falsonix/picoAVE/production_gerbers/README.md

This directory contains pre-compiled gerber files that can be uploaded to a manufacturer like JLCPCB or PCBWay, along with the BOM.csv and Positions.csv files for assembly services.
