falsonix/picoAVE/hardware/hdmi_pcb/README.md

Adapted from https://github.com/wmi-0/wiihdmi/tree/master/hdmi_pcb/kicad

License: [GPL v3](https://github.com/wmi-0/wiihdmi/blob/master/LICENSE)
