falsonix/picoAVE/hardware/wii_flex/wii_flex.kicad_pcb

## KiCad design hardware/wii_flex/wii_flex.kicad_pcb (2025-01-12)

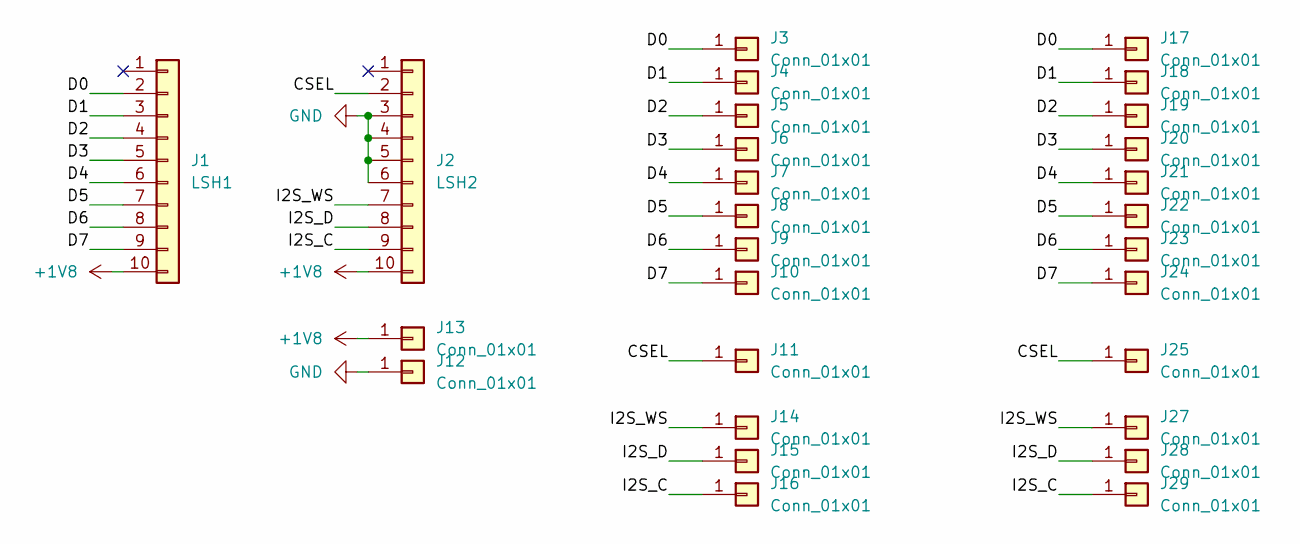
[picture p1: schematic wii_flex.kicad_sch]

Parts:
J1: LSH1; PinHeader_1x10_P2.54mm_Vertical
J2: LSH2; PinHeader_1x10_P2.54mm_Vertical
J3, J4, J5, J6, J7, J8, J9, J10, J11, J14, J15, J16, J17, J18, J19, J20, J21, J22, J23, J24, J25, J27, J28, J29: Conn_01x01; wii_pin
J12, J13: Conn_01x01; TestPoint_Pad_2.0x2.0mm

Connections:
+1V8: J1.10, J2.10, J13.1
/CSEL: J2.2, J11.1, J25.1
/D0: J1.2, J3.1, J17.1
/D1: J1.3, J4.1, J18.1
/D2: J1.4, J5.1, J19.1
/D3: J1.5, J6.1, J20.1
/D4: J1.6, J7.1, J21.1
/D5: J1.7, J8.1, J22.1
/D6: J1.8, J9.1, J23.1
/D7: J1.9, J10.1, J24.1
/I2S_C: J2.9, J16.1, J29.1
/I2S_D: J2.8, J15.1, J28.1
/I2S_WS: J2.7, J14.1, J27.1
GND: J2.3, J2.4, J2.5, J2.6, J12.1

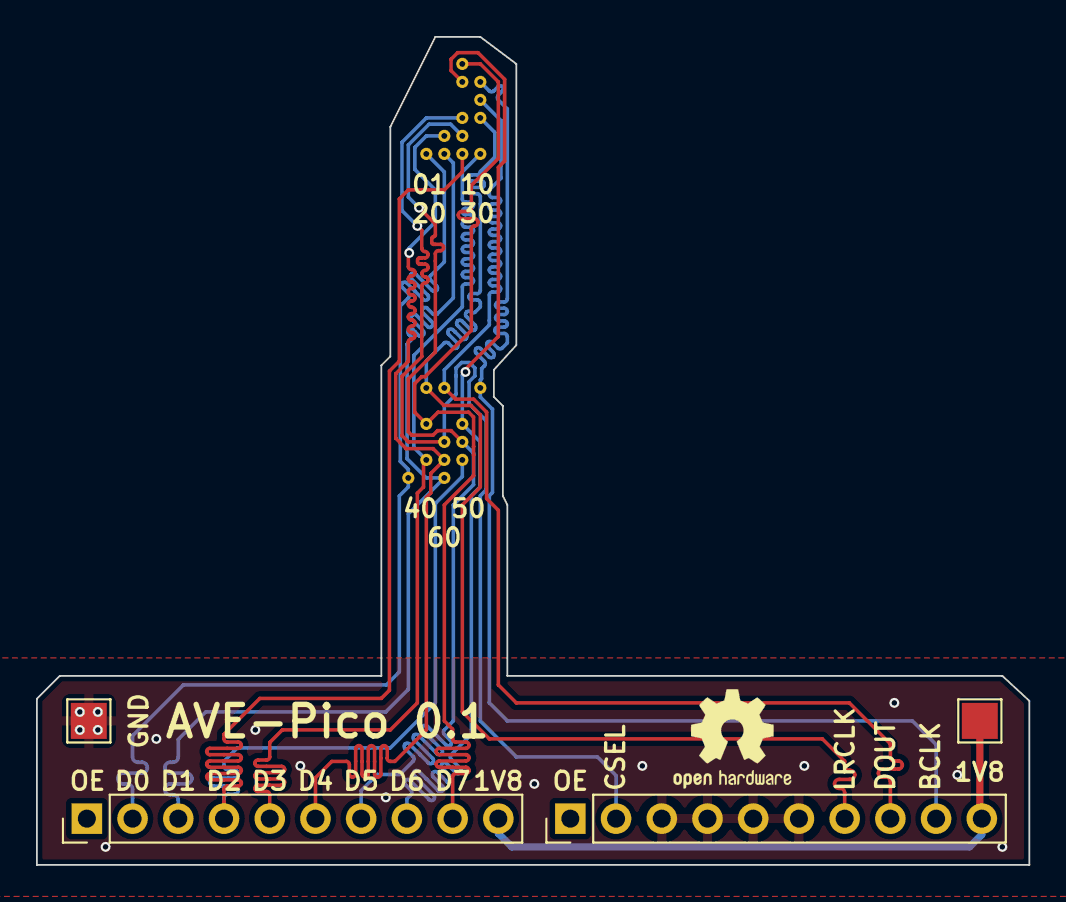
[picture p2: board wii_flex.kicad_pcb from above]

Board: 2 copper layers, 55.1 x 46.0 mm, 28 parts (0 on the bottom side), 14 nets.
