falsonix/picoAVE/hardware/hdmi_pcb/wii_hdmi_pcb.kicad_pcb

## KiCad design hardware/hdmi_pcb/wii_hdmi_pcb.kicad_pcb (2025-01-12)

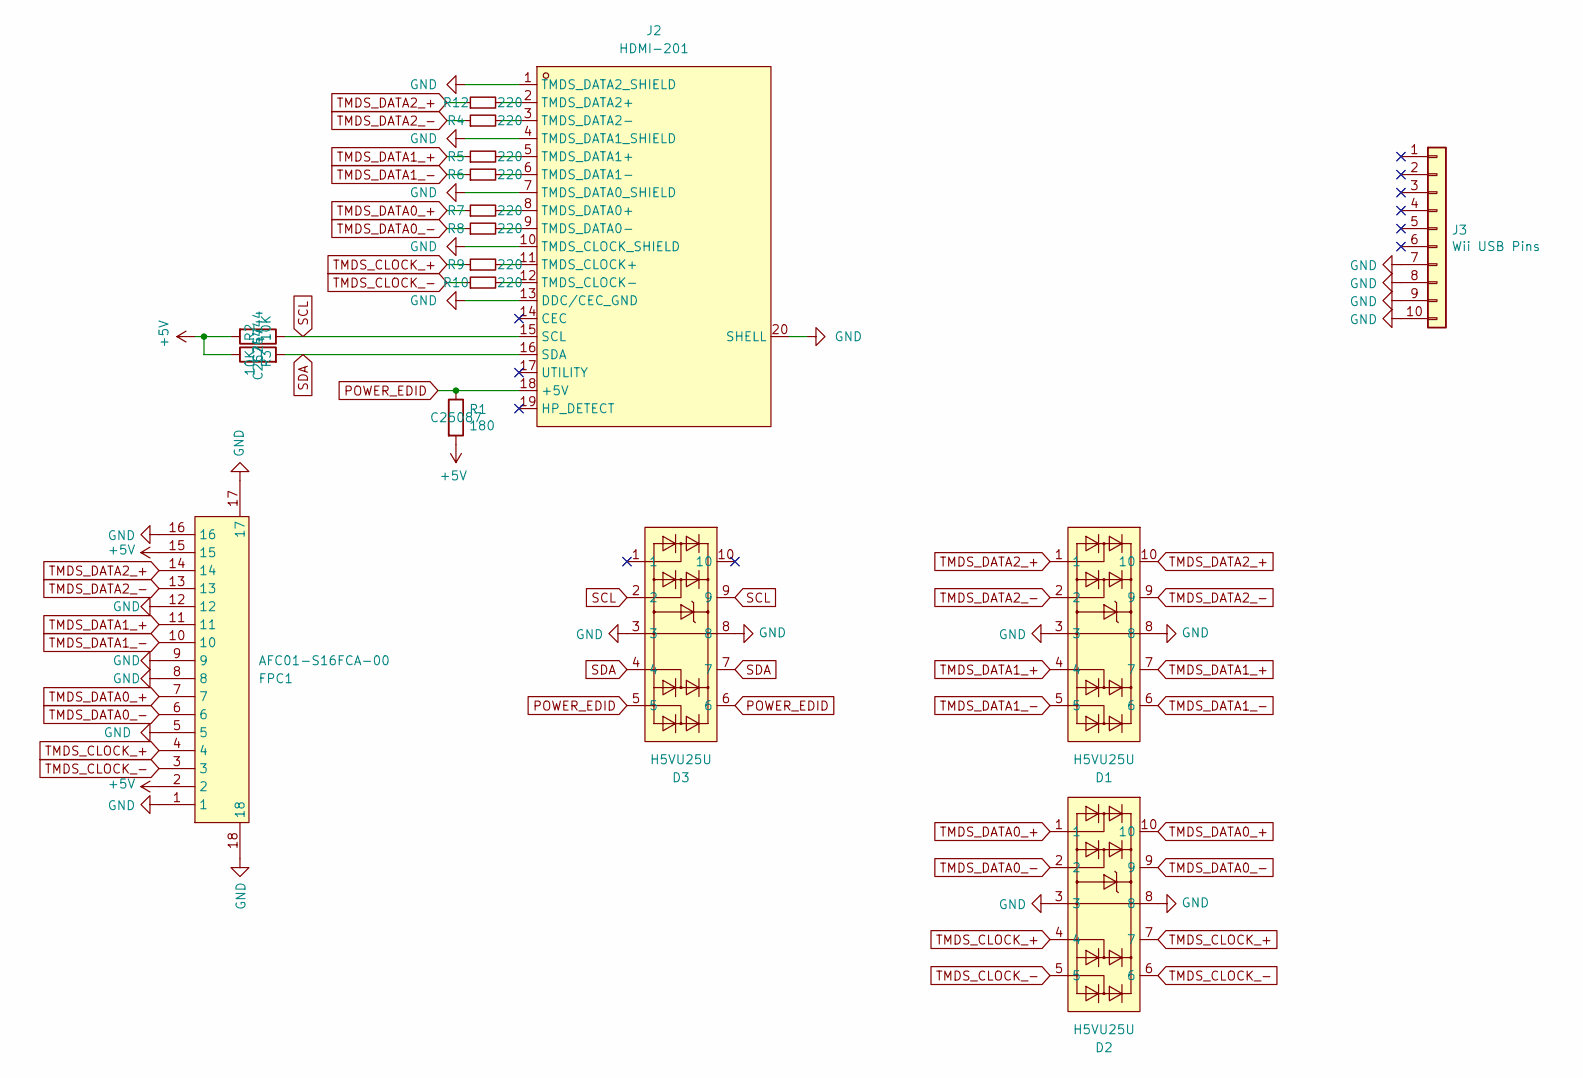
[picture p3: schematic wii_hdmi_pcb.kicad_sch]

Parts:
D1, D2, D3: H5VU25U; DFN2510-10_L2.5-W1.0-P0.50-BL; LCSC Part C7420374
FPC1: AFC01-S16FCA-00; FPC-SMD_P0.50-16P_FGS-XJ-H2.0; LCSC Part C262665
J2: HDMI-201; HDMI-SMD_HDMI-201; LCSC Part C720618
J3: Wii USB Pins; Wii USB Port
R1: 180; R_0402_1005Metric; JLC Part C25087
R2, R3: 10K; R_0402_1005Metric; JLC Part C25744
R4, R5, R6, R7, R8, R9, R10, R12: 220; R_0402_1005Metric; JLC Part C25091

Connections:
+5V: FPC1.2, FPC1.15, R1.2, R2.1, R3.2
GND: D1.3, D1.8, D2.3, D2.8, D3.3, D3.8, FPC1.1, FPC1.5, FPC1.8, FPC1.9, FPC1.12, FPC1.16, FPC1.17, FPC1.18, J2.1 (TMDS_DATA2_SHIELD), J2.4 (TMDS_DATA1_SHIELD), J2.7 (TMDS_DATA0_SHIELD), J2.10 (TMDS_CLOCK_SHIELD), J2.13 (DDC/CEC_GND), J2.20 (SHELL), J3.7, J3.8, J3.9, J3.10
unnamed: J2.11 (TMDS_CLOCK+), R9.2
unnamed: J2.12 (TMDS_CLOCK-), R10.2
unnamed: J2.8 (TMDS_DATA0+), R7.2
unnamed: J2.9 (TMDS_DATA0-), R8.2
unnamed: J2.5 (TMDS_DATA1+), R5.2
unnamed: J2.6 (TMDS_DATA1-), R6.2
unnamed: J2.2 (TMDS_DATA2+), R12.2
unnamed: J2.3 (TMDS_DATA2-), R4.2
POWER_EDID: D3.5, D3.6, J2.18 (+5V), R1.1
SCL: D3.2, D3.9, J2.15 (SCL), R3.1
SDA: D3.4, D3.7, J2.16 (SDA), R2.2
TMDS_CLOCK_+: D2.4, D2.7, FPC1.4, R9.1
TMDS_CLOCK_-: D2.5, D2.6, FPC1.3, R10.1
TMDS_DATA0_+: D2.1, D2.10, FPC1.7, R7.1
TMDS_DATA0_-: D2.2, D2.9, FPC1.6, R8.1
TMDS_DATA1_+: D1.4, D1.7, FPC1.11, R5.1
TMDS_DATA1_-: D1.5, D1.6, FPC1.10, R6.1
TMDS_DATA2_+: D1.1, D1.10, FPC1.14, R12.1
TMDS_DATA2_-: D1.2, D1.9, FPC1.13, R4.1

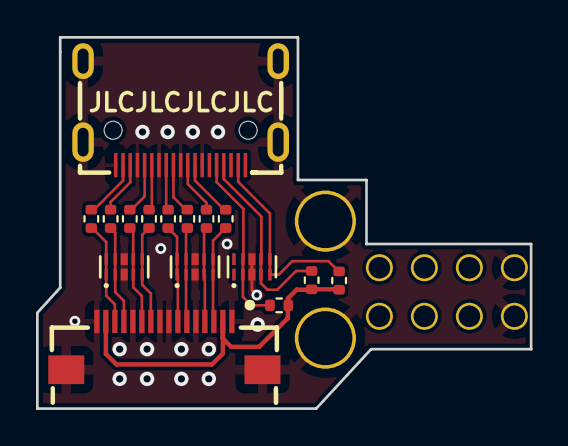
[picture p4: board wii_hdmi_pcb.kicad_pcb from above]

Board: 2 copper layers, 27.4 x 20.6 mm, 17 parts (0 on the bottom side), 21 nets.
