falsonix/picoAVE/hardware/wii_mainboard/wii_mainboard.kicad_pcb

## KiCad design hardware/wii_mainboard/wii_mainboard.kicad_pcb (2025-01-12)

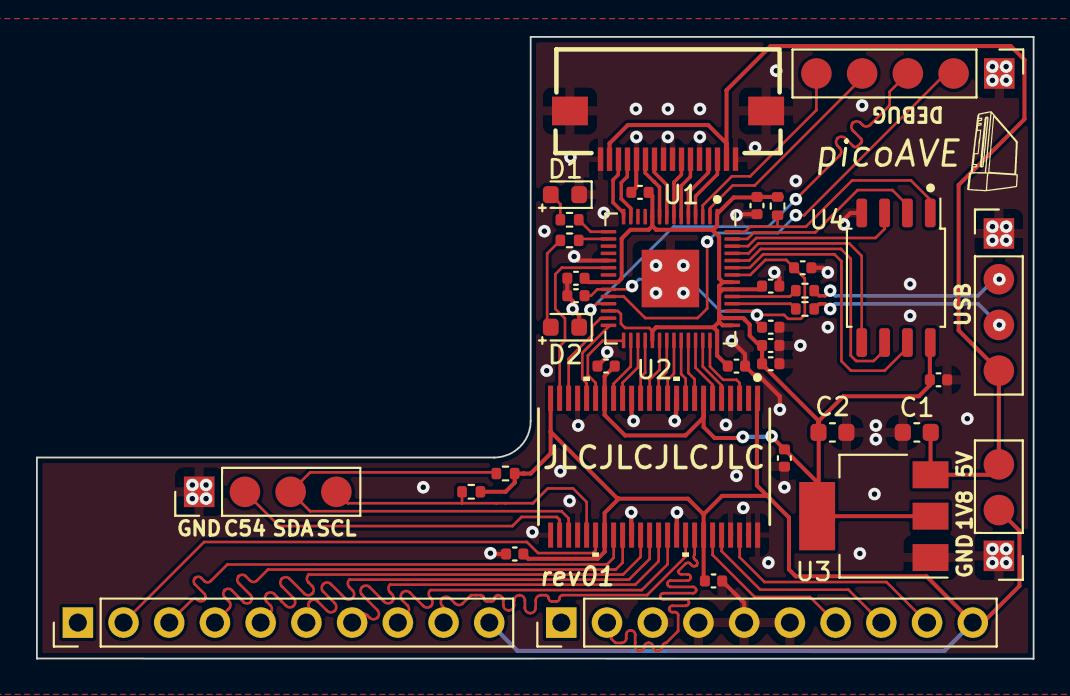
[picture p5: board wii_mainboard.kicad_pcb from above]

Board: 2 copper layers, 55.4 x 34.5 mm, 37 parts (0 on the bottom side), 61 nets.

Parts:
C1: 10uF; C_0603_1608Metric
C2: 22uF; C_0603_1608Metric
C3, C4, C7, C8, C9, C10, C11, C12, C13, C14, C15, C16, C17: 100nF; C_0402_1005Metric
C5, C6: 1uF; C_0402_1005Metric
D1, D2: LED; LED_0603_1608Metric_plus
FFC1: AFC01-S16FCA-00; FPC-SMD_P0.50-16P_FGS-XJ-H2.0
J1: USB; PinHeader_1x04_P2.54mm_Vertical
J3: Data1; PinHeader_1x10_P2.54mm_Vertical
J4: Data2; PinHeader_1x10_P2.54mm_Vertical
J5: Power; PinHeader_1x03_P2.54mm_Vertical
J6: Data0; PinHeader_1x04_P2.54mm_Vertical
J7: Debug; PinHeader_1x05_P2.54mm_Vertical
R1, R2: 470; R_0402_1005Metric
R3, R6, R7: 10k; R_0402_1005Metric
R4, R5: 33; R_0402_1005Metric
U1: RP2040; QFN-56-1EP_7x7mm_P0.4mm_EP3.2x3.2mm
U2: 74AVC16T245DGGRE; DGG48
U3: AMS1117-3.3; SOT-223-3_TabPin2
U4: W25Q128JVS; SOIC-8_5.23x5.23mm_P1.27mm

Connections:
+1V1: C3.1, C4.1, C5.1, U1.23 (DVDD), U1.45 (VREG_VOUT), U1.50 (DVDD)
+1V8: C16.1, C17.1, J3.10, J4.10, J5.2, R6.1, R7.1, U2.1 (1DIR), U2.24 (2DIR), U2.31 (VCCA), U2.42 (VCCA)
+3V3: C2.1, C6.1, C7.1, C8.1, C9.1, C10.1, C11.1, C12.1, C13.1, C14.1, C15.1, R3.2, U1.1 (IOVDD), U1.10 (IOVDD), U1.22 (IOVDD), U1.26 (RUN), U1.33 (IOVDD), U1.42 (IOVDD), U1.43 (ADC_AVDD), U1.44 (VREG_IN), U1.48 (USB_VDD), U1.49 (IOVDD), U2.7 (VCCB), U2.18 (VCCB), U3.2 (VO), U4.8 (VCC)
+5V: C1.1, FFC1.2, FFC1.15, J1.4, J5.3, U3.3 (VI)
/DVI_0+: FFC1.7, U1.8 (GPIO6)
/DVI_0-: FFC1.6, U1.9 (GPIO7)
/DVI_1+: FFC1.11, U1.6 (GPIO4)
/DVI_1-: FFC1.10, U1.7 (GPIO5)
/DVI_2+: FFC1.14, U1.4 (GPIO2)
/DVI_2-: FFC1.13, U1.5 (GPIO3)
/DVI_C+: FFC1.4, U1.13 (GPIO10)
/DVI_C-: FFC1.3, U1.14 (GPIO11)
/I2C_CLK: U1.28 (GPIO17), U2.20 (2B6)
/I2C_DATA: U1.27 (GPIO16), U2.22 (2B7)
/LED0: R1.2, U1.15 (GPIO12)
/LED1: R2.2, U1.16 (GPIO13)
/LV_I2C_CLK: J6.4, R7.2, U2.29 (2A6)
/LV_I2C_DATA: J6.3, R6.2, U2.27 (2A7)
/LV_WII_54CLK: J6.2, U2.26 (2A8)
/LV_WII_BCLK: J4.9, U2.46 (1A2)
/LV_WII_CSEL: J4.2, U2.41 (1A5)
/LV_WII_D0: J3.2, U2.30 (2A5)
/LV_WII_D1: J3.3, U2.32 (2A4)
/LV_WII_D2: J3.4, U2.33 (2A3)
/LV_WII_D3: J3.5, U2.35 (2A2)
/LV_WII_D4: J3.6, U2.36 (2A1)
/LV_WII_D5: J3.7, U2.37 (1A8)
/LV_WII_D6: J3.8, U2.38 (1A7)
/LV_WII_D7: J3.9, U2.40 (1A6)
/LV_WII_DOUT: J4.8, U2.44 (1A3)
/LV_WII_LRCLK: J4.7, U2.43 (1A4)
/QSPI_SCLK: U1.52 (QSPI_SCLK), U4.6 (CLK)
/QSPI_SD0: U1.53 (QSPI_SD0), U4.5 (DI(IO0))
/QSPI_SD1: U1.55 (QSPI_SD1), U4.2 (DO(IO1))
/QSPI_SD2: U1.54 (QSPI_SD2), U4.3 (IO2)
/QSPI_SD3: U1.51 (QSPI_SD3), U4.7 (IO3)
/QSPI_SS: R3.1, U1.56 (QSPI_SS), U4.1 (~CS)
/RX: J7.5, U1.3 (GPIO1)
/SWCLK: J7.2, U1.24 (SWCLK)
/SWD: J7.3, U1.25 (SWD)
/TX: J7.4, U1.2 (GPIO0)
/USB_D+: J1.2, R4.1
/USB_D-: J1.3, R5.1
/WII_54CLK: U1.20 (XIN), U2.23 (2B8)
/WII_BCLK: U1.41 (GPIO29_ADC3), U2.3 (1B2)
/WII_CSEL: U1.38 (GPIO26_ADC0), U2.8 (1B5)
/WII_D0: U1.29 (GPIO18), U2.19 (2B5)
/WII_D1: U1.30 (GPIO19), U2.17 (2B4)
/WII_D2: U1.31 (GPIO20), U2.16 (2B3)
/WII_D3: U1.32 (GPIO21), U2.14 (2B2)
/WII_D4: U1.34 (GPIO22), U2.13 (2B1)
/WII_D5: U1.35 (GPIO23), U2.12 (1B8)
/WII_D6: U1.36 (GPIO24), U2.11 (1B7)
/WII_D7: U1.37 (GPIO25), U2.9 (1B6)
/WII_DOUT: U1.40 (GPIO28_ADC2), U2.5 (1B3)
/WII_LRCLK: U1.39 (GPIO27_ADC1), U2.6 (1B4)
GND: C1.2, C2.2, C3.2, C4.2, C5.2, C6.2, C7.2, C8.2, C9.2, C10.2, C11.2, C12.2, C13.2, C14.2, C15.2, C16.2, C17.2, D1.1 (K), D2.1 (K), FFC1.1, FFC1.5, FFC1.8, FFC1.9, FFC1.12, FFC1.16, FFC1.17, FFC1.18, J1.1, J4.3, J4.4, J4.5, J4.6, J5.1, J6.1, J7.1, U1.19 (TESTEN), U1.57 (GND), U2.4 (GND), U2.10 (GND), U2.15 (GND), U2.21 (GND), U2.25 (*2OE), U2.28 (GND), U2.34 (GND), U2.39 (GND), U2.45 (GND), U2.47 (1A1), U2.48 (*1OE), U3.1 (GND), U4.4 (GND)
unnamed: D1.2 (A), R1.1
unnamed: D2.2 (A), R2.1
unnamed: R5.2, U1.46 (USB_DM)
unnamed: R4.2, U1.47 (USB_DP)
