falsonix/picoAVE/(commit log)

2025-01-12 Add section about ordering and assembly
2025-01-12 PCB project files
    [wii_flex.kicad_pcb, wii_flex.kicad_sch, wii_hdmi_pcb.kicad_pcb, wii_hdmi_pcb.kicad_sch, wii_mainboard.kicad_pcb, wii_mainboard.kicad_sch]
2025-06-11 add gerber files
